Snake54310/Gloves/Technical Addendum/Flex_Gyro_Zeroing_Demo/Fist_1.jpg

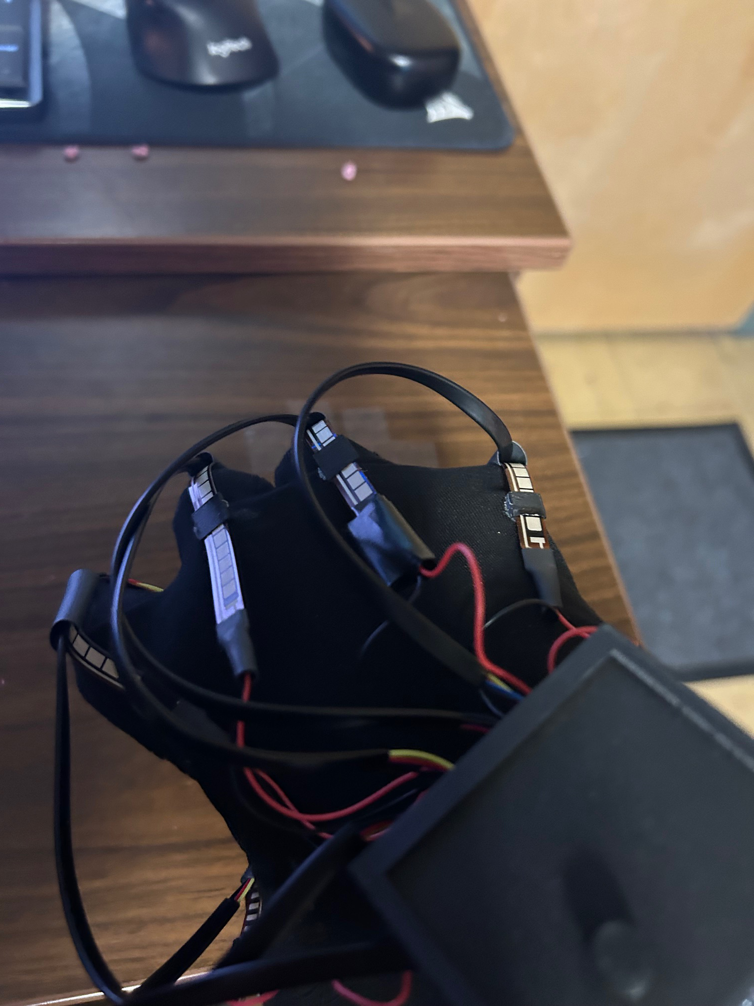
Technical Addendum/Flex_Gyro_Zeroing_Demo/Fist_1.jpg
