Snake54310/Gloves/Technical Addendum/Flex_Gyro_Zeroing_Demo/Fist_4.jpg

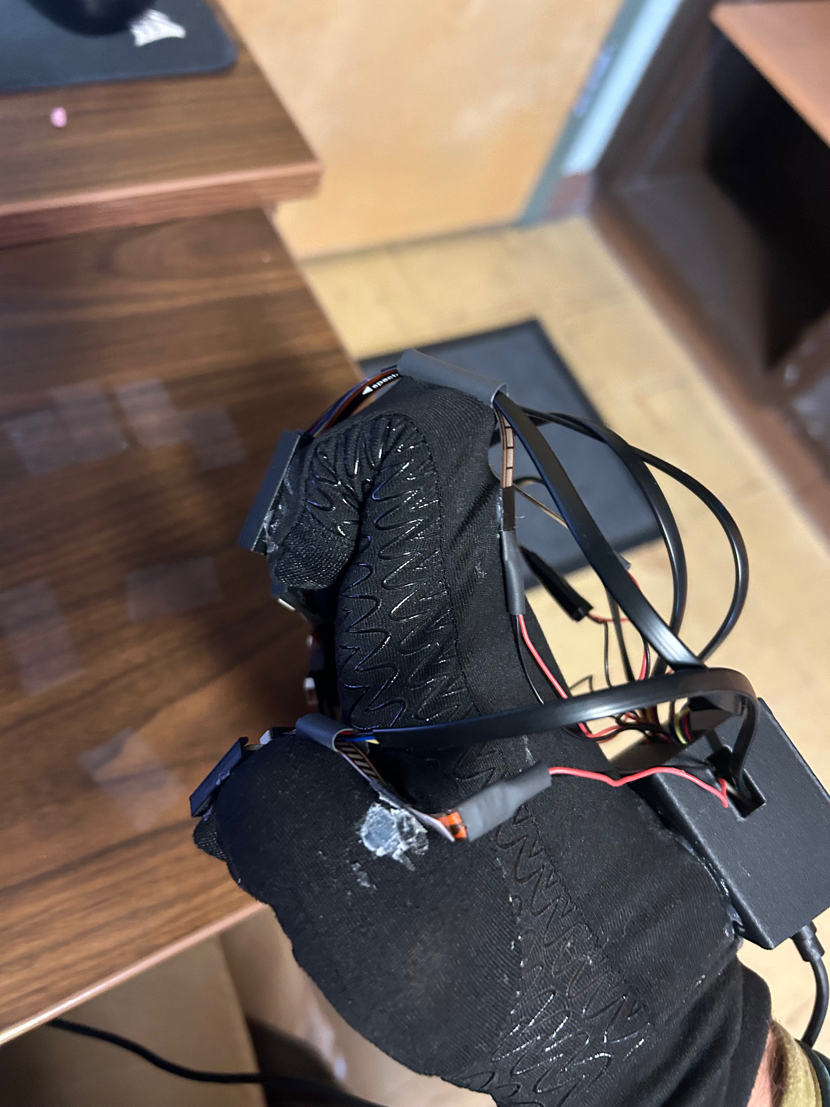
Technical Addendum/Flex_Gyro_Zeroing_Demo/Fist_4.jpg
