Snake54310/Gloves/Technical Addendum/Tech Addendum Drawings.docx

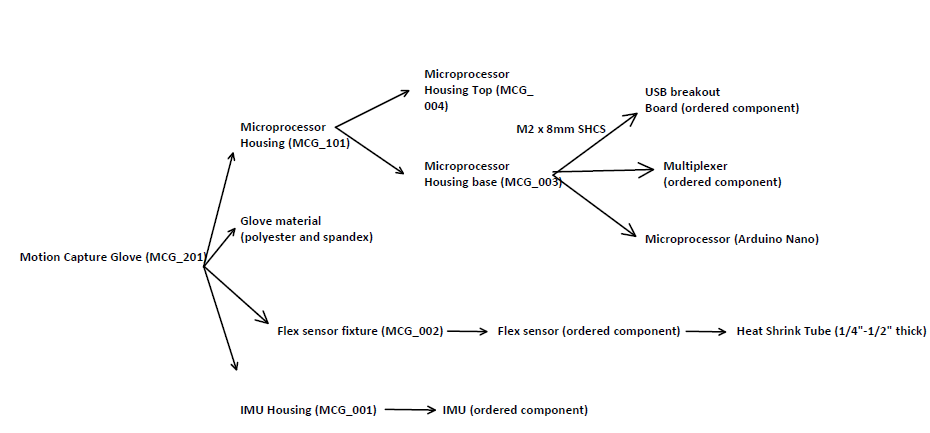
[picture p3: figure]

Figure xx: MoCap component diagram tree

All parts manufactured in-house should follow the same nomenclature as seen above. MCG_ indicating (MoCap glove), value in the tenths place indicates the file type: 200 – main assembly, 100 – sub-assembly, and 000 – single component. The hundredth and thousandth place are dedicated solely to which part you are working with. Drawings for the modeled component can be seen below.

Following the drawings are ECNs (Engineering Change Notification), created throughout the manufacturing process. The changes are direct products of trial and error upon printing the housing for the components. Each change is linked to a component and can be found in the upper right of the ECN document

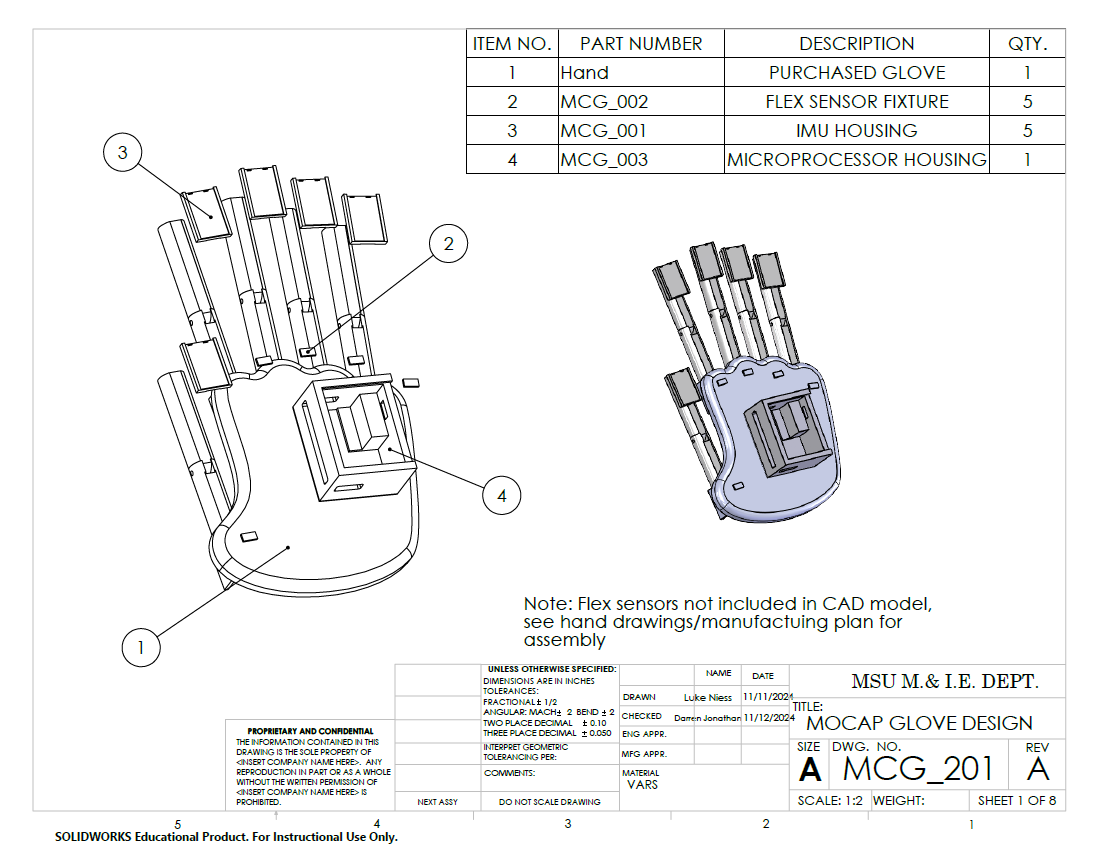
[picture p4: figure]
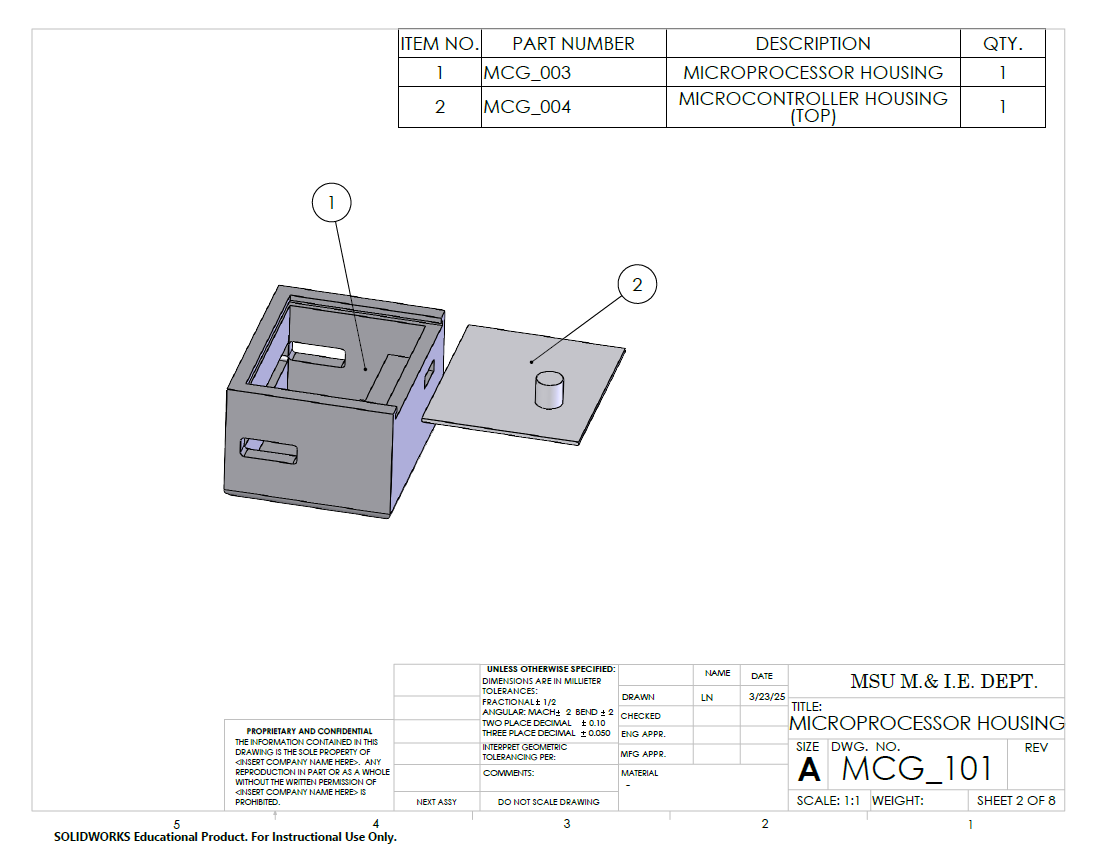
[picture p5: figure]
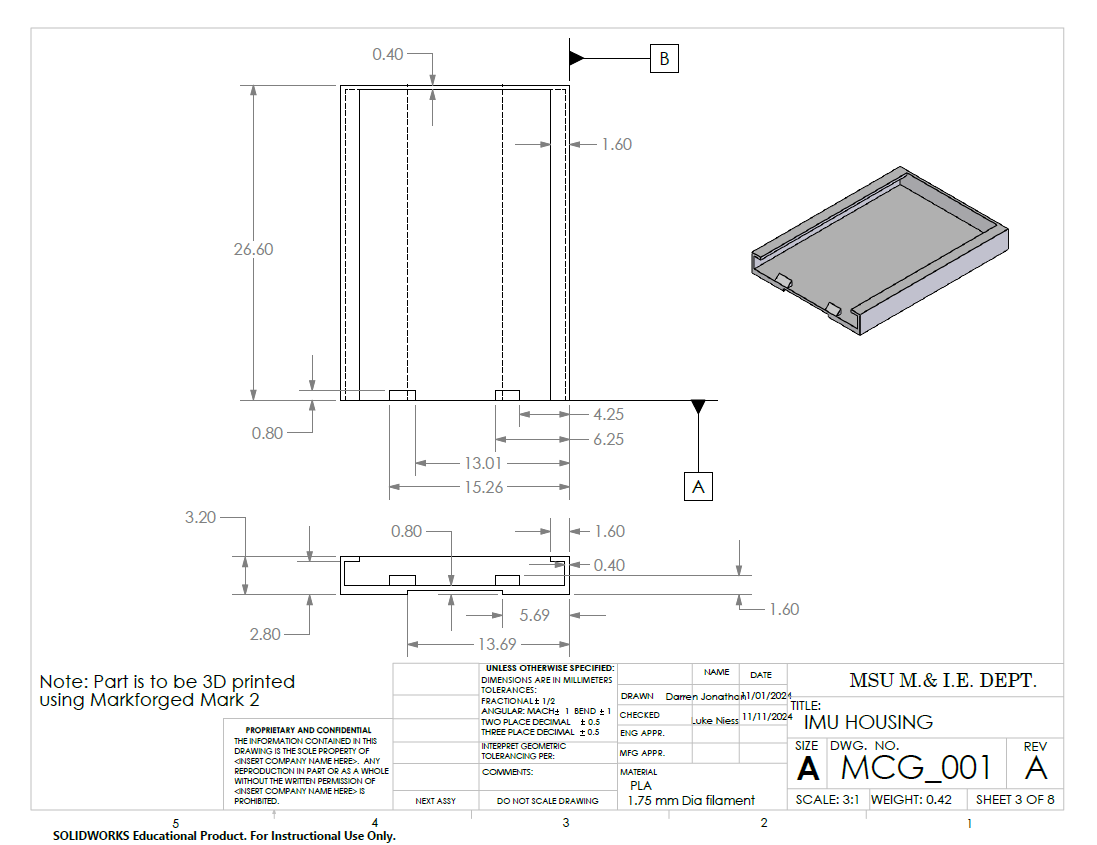
[picture p6: figure]
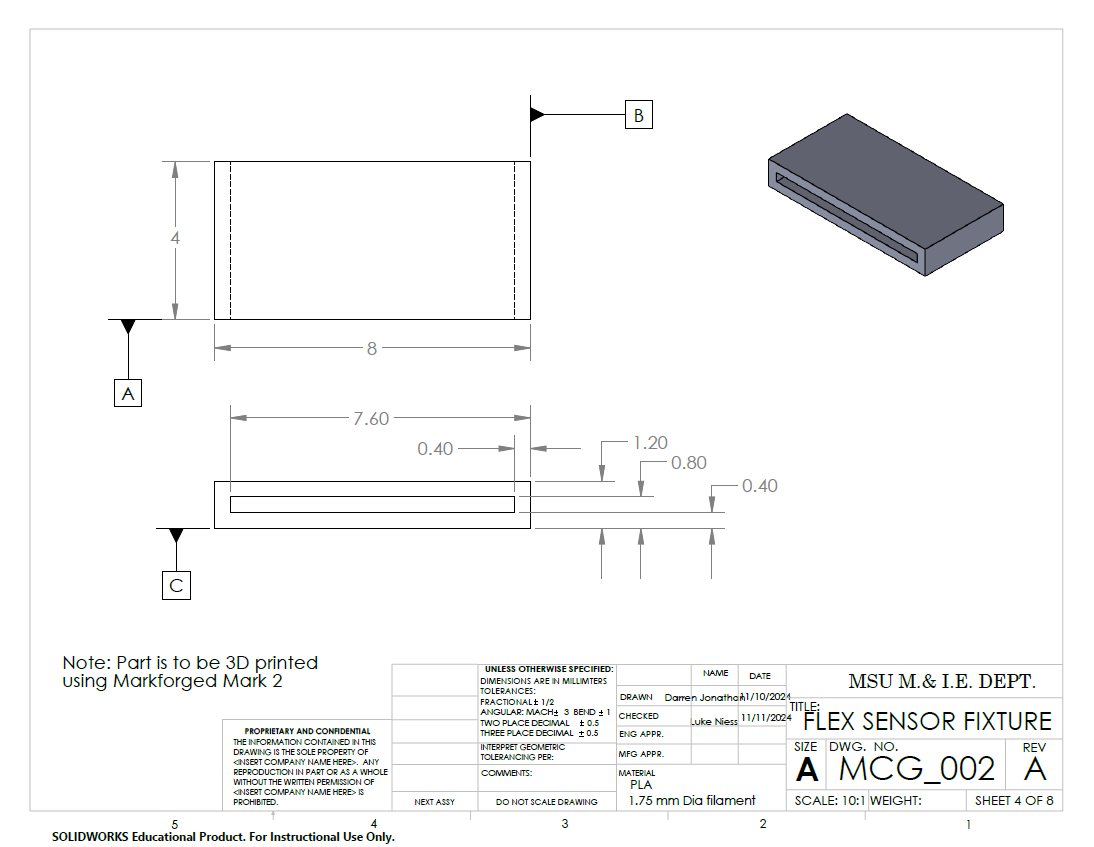
[picture p7: figure]
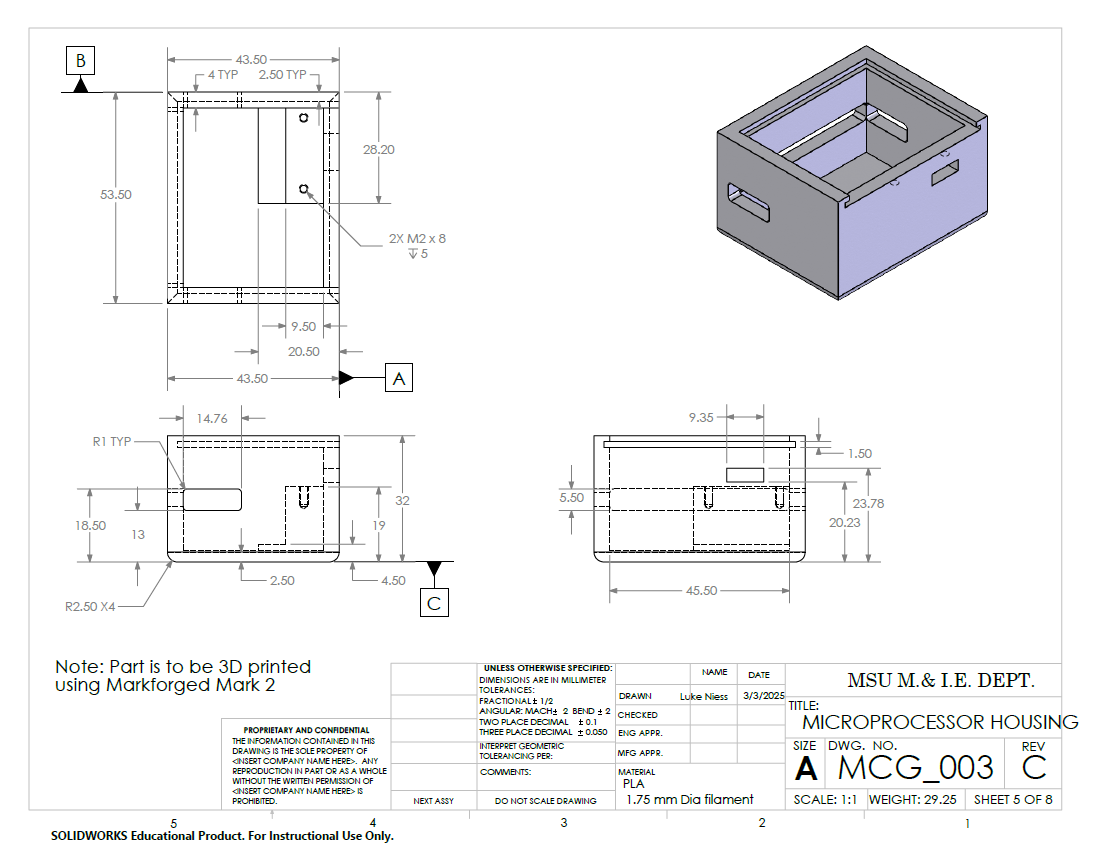
[picture p8: figure]
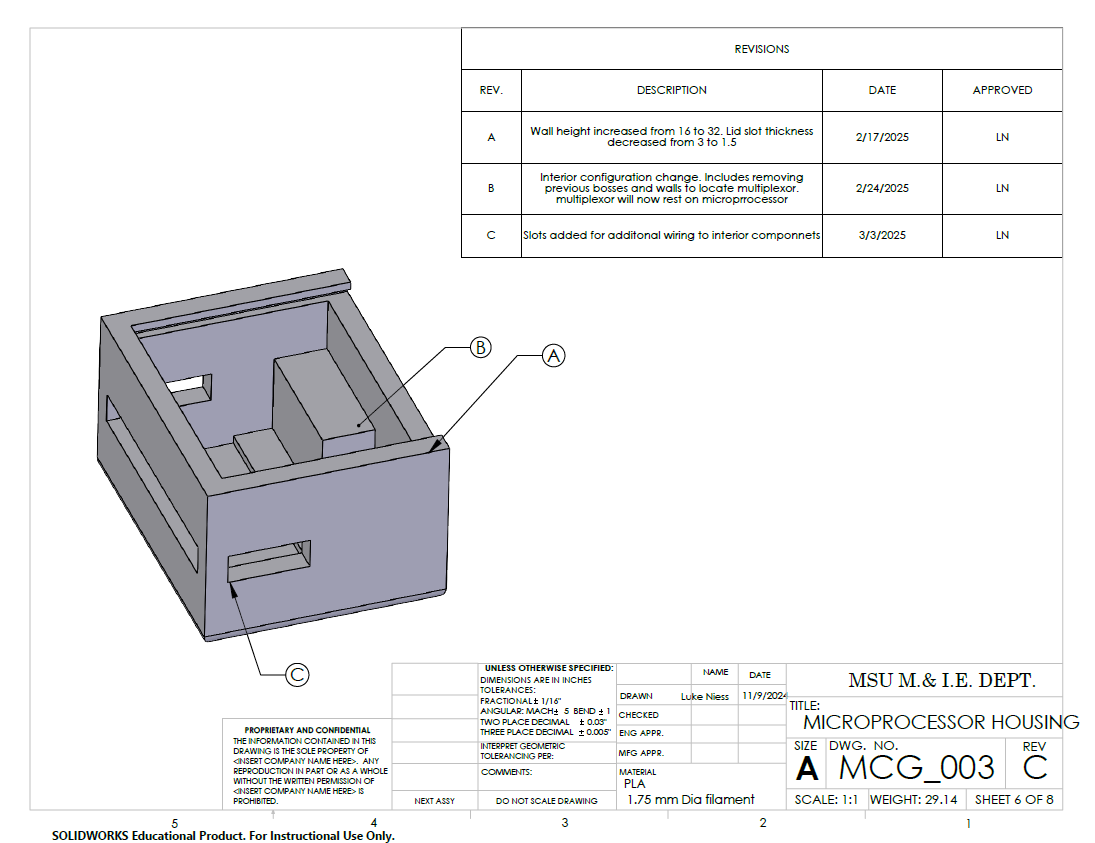
[picture p9: figure]
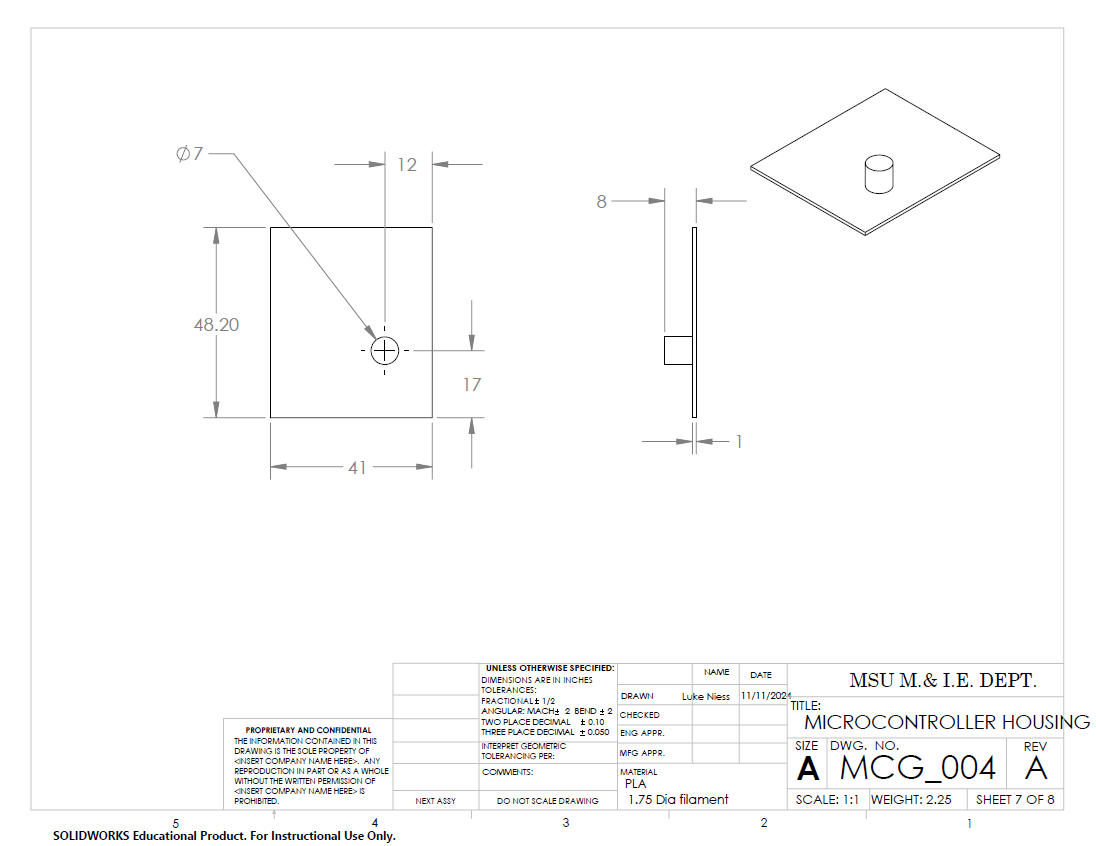
[picture p10: figure]
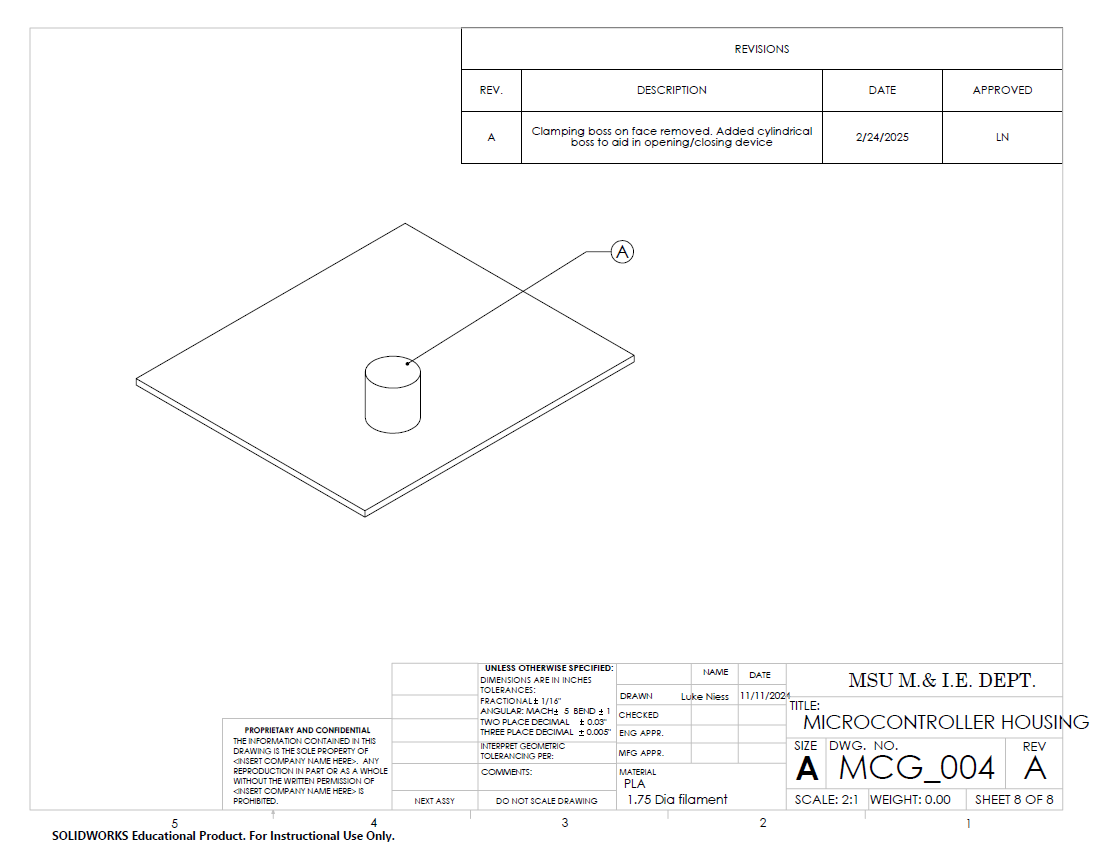
[picture p11: figure]
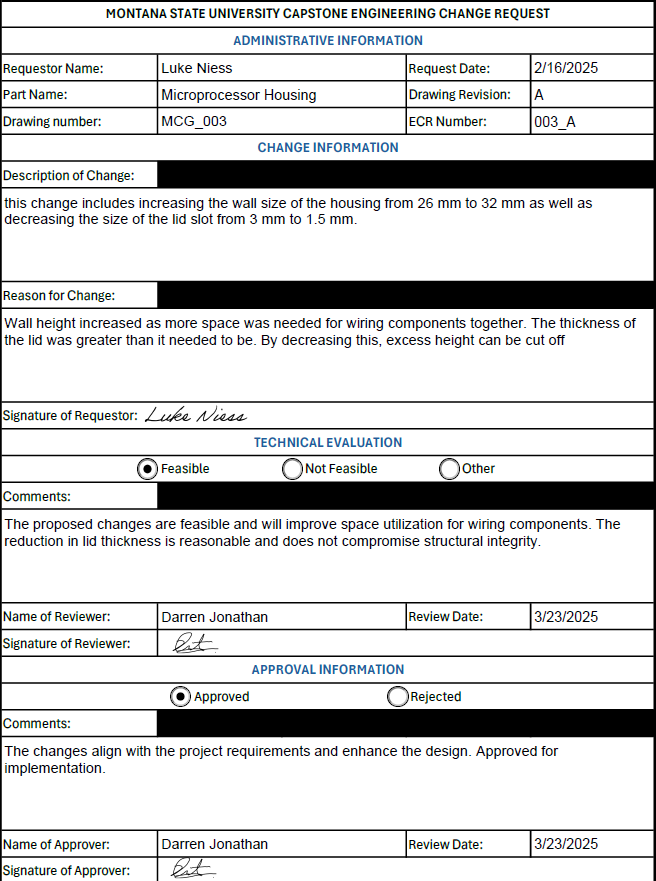
[picture p12: figure]
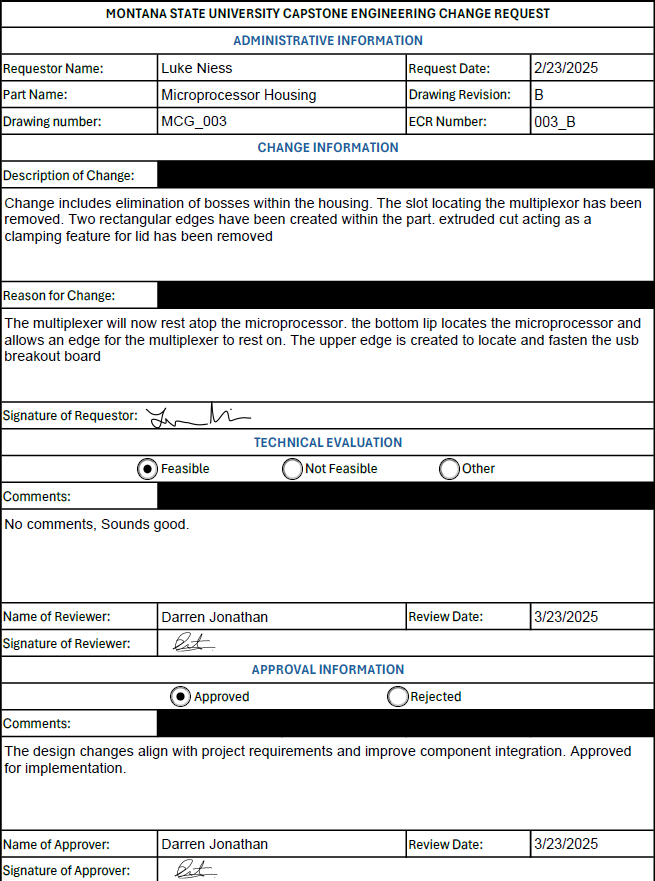
[picture p13: figure]
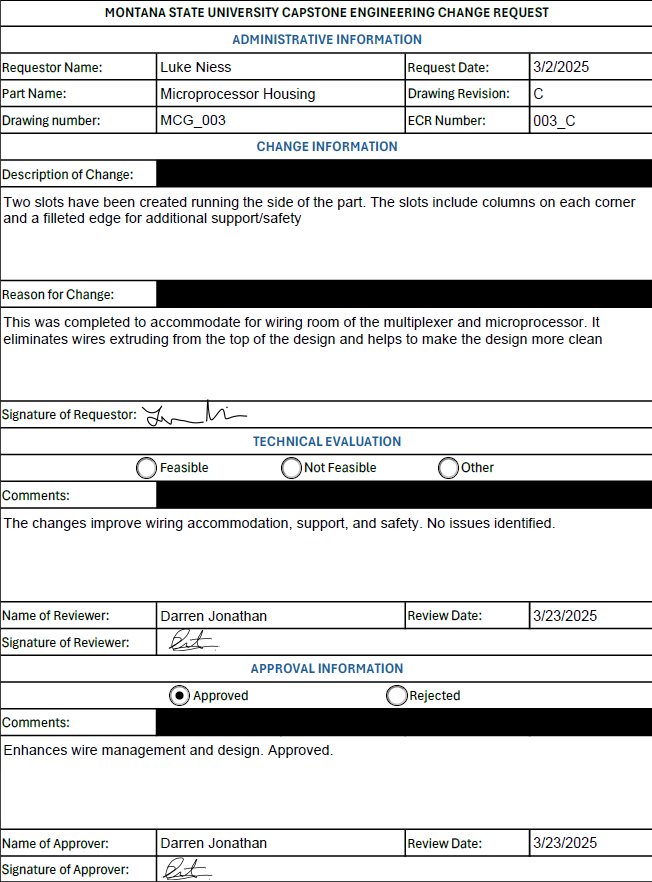
[picture p14: figure]
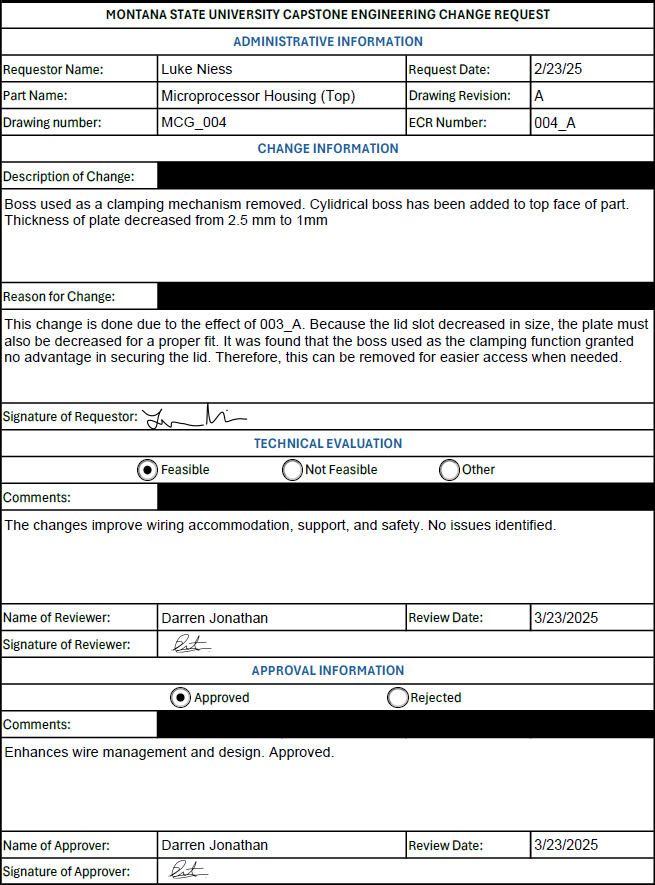
[picture p15: figure]
