Snake54310/Gloves/Technical Addendum/gantt_chart_final.pdf

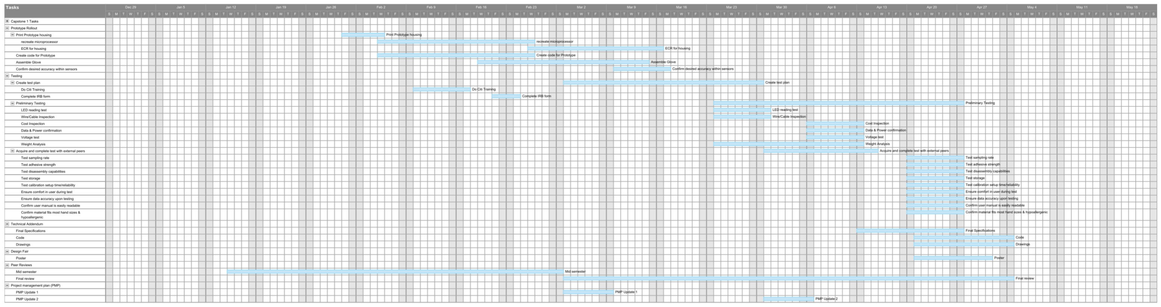
[picture p16: page 1]
