Snake54310/Gloves/Technical Addendum/Code Screenshots/arduino_1.jpg

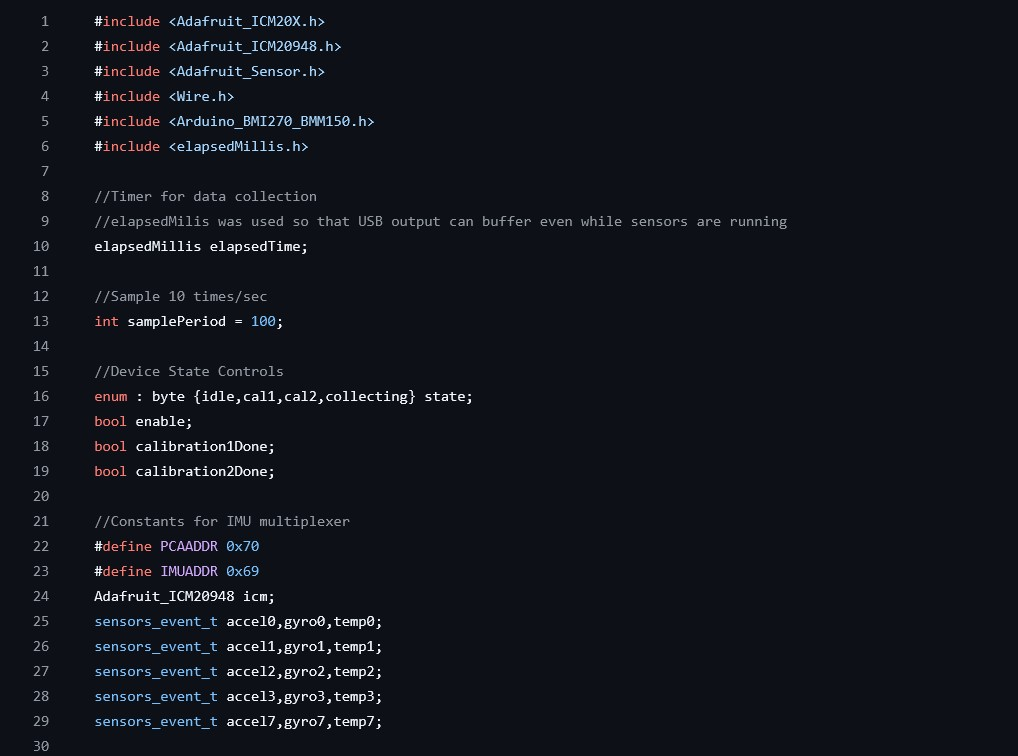
Technical Addendum/Code Screenshots/arduino_1.jpg
