Snake54310/Gloves/Technical Addendum/Code Screenshots/arduino_4_left.jpg

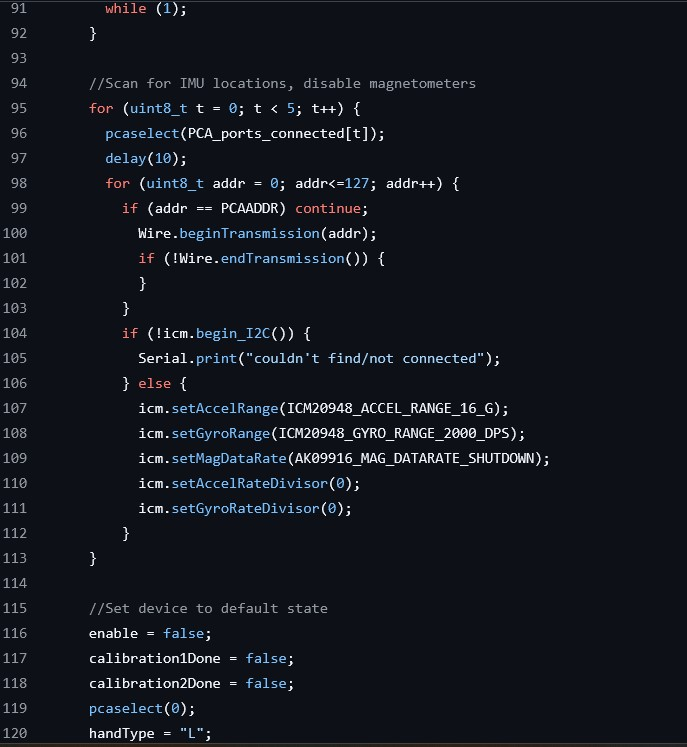
Technical Addendum/Code Screenshots/arduino_4_left.jpg
