Snake54310/Gloves/Technical Addendum/Code Screenshots/arduino_4_right.jpg

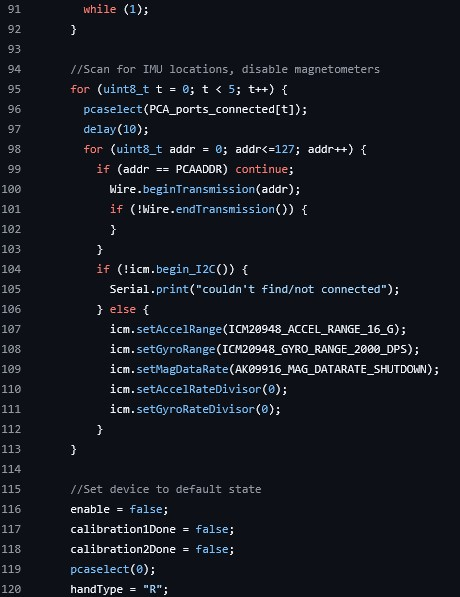
Technical Addendum/Code Screenshots/arduino_4_right.jpg
