Snake54310/Gloves/Technical Addendum/Code Screenshots/arduino_5.jpg

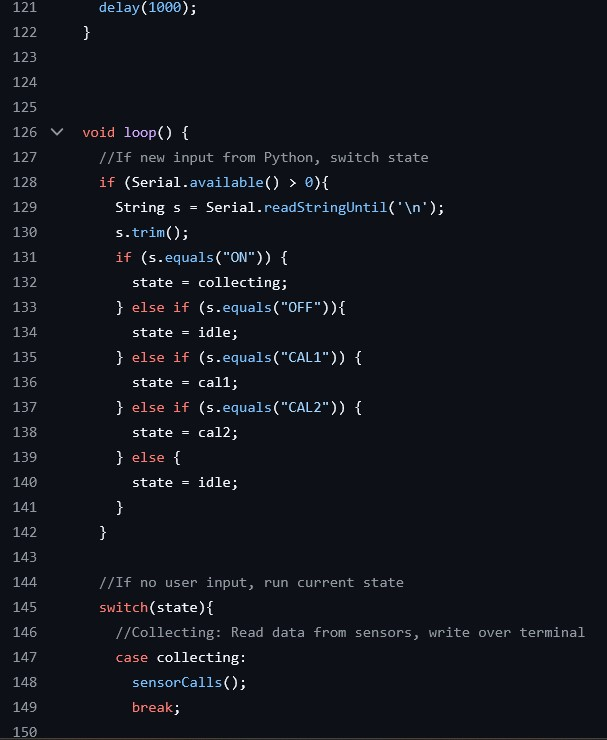
Technical Addendum/Code Screenshots/arduino_5.jpg
