Snake54310/Gloves/Technical Addendum/Code Screenshots/arduino_7.jpg

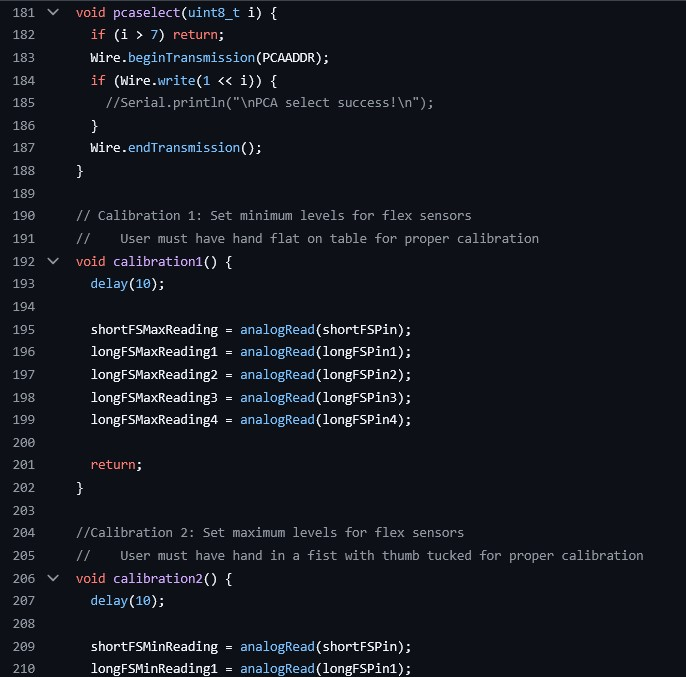
Technical Addendum/Code Screenshots/arduino_7.jpg
