Snake54310/Gloves/Technical Addendum/Code Screenshots/arduino_8.jpg

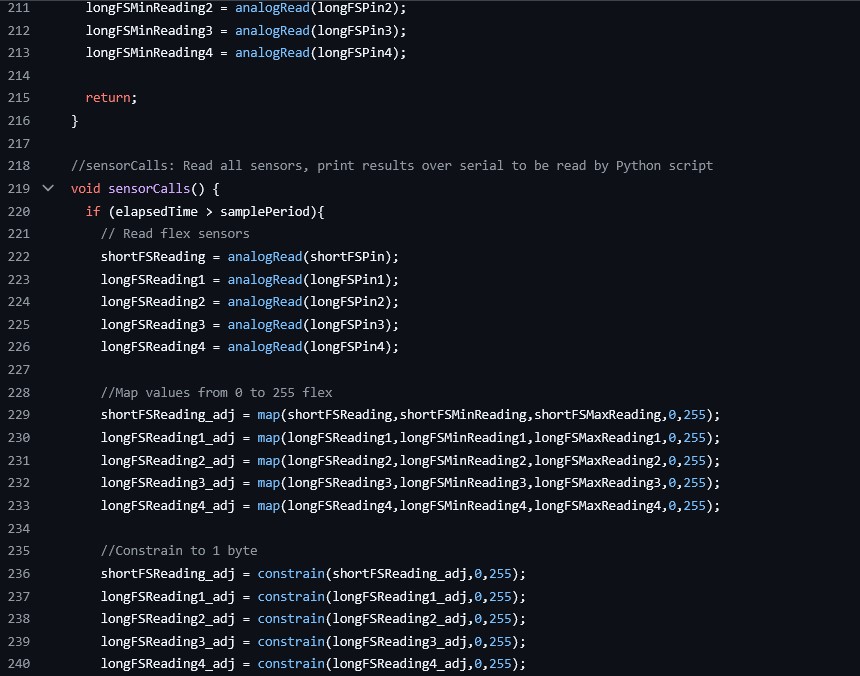
Technical Addendum/Code Screenshots/arduino_8.jpg
