Snake54310/Gloves/Technical Addendum/Code Screenshots/arduino_9.jpg

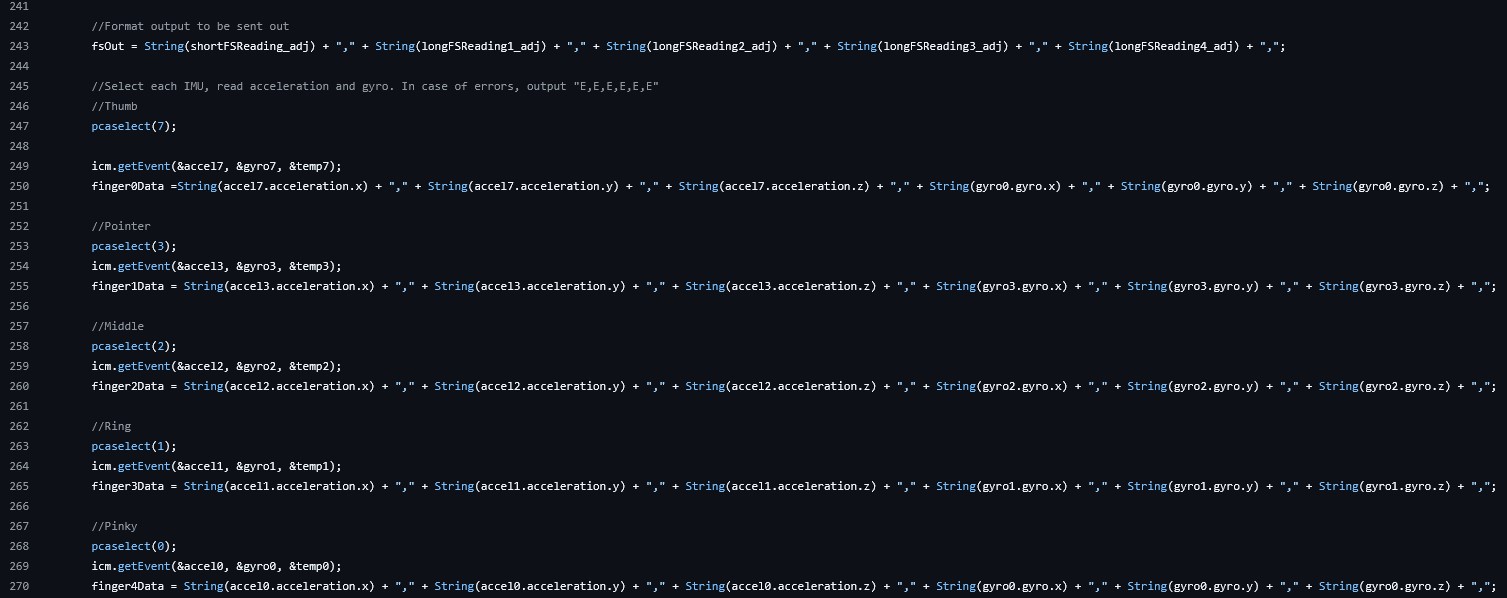
Technical Addendum/Code Screenshots/arduino_9.jpg
