Snake54310/Gloves/Technical Addendum/Code Screenshots/arduino_10.jpg

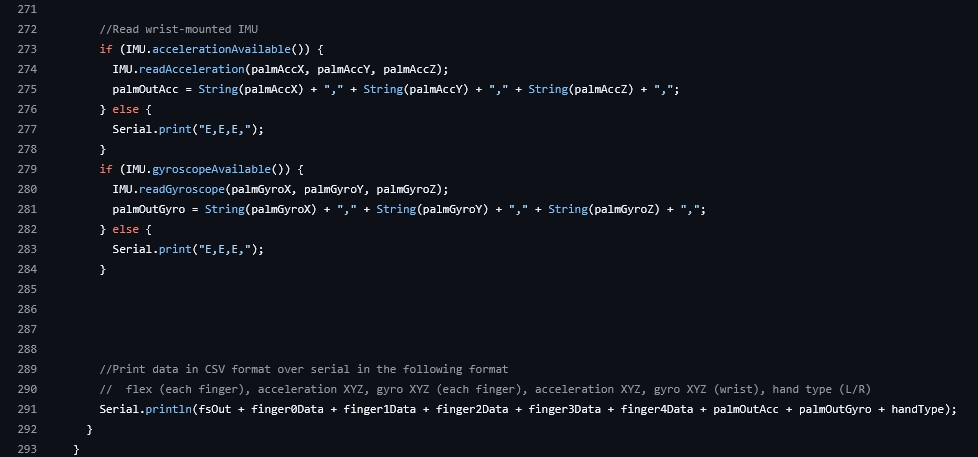
Technical Addendum/Code Screenshots/arduino_10.jpg
