Snake54310/Gloves/Technical Addendum/Flex_Gyro_Zeroing_Demo/Flat_2.jpg

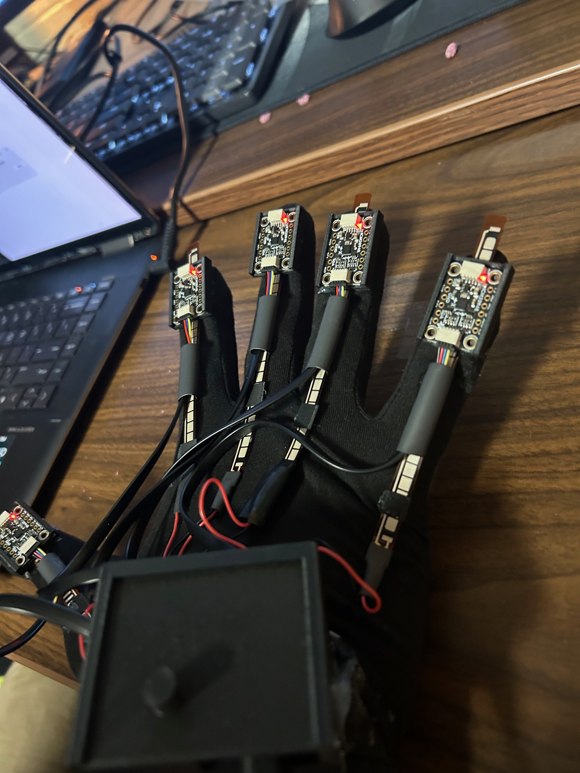
Technical Addendum/Flex_Gyro_Zeroing_Demo/Flat_2.jpg
