Snake54310/Gloves/Technical Addendum/Flex_Gyro_Zeroing_Demo/Gyro_Zeroing.jpg

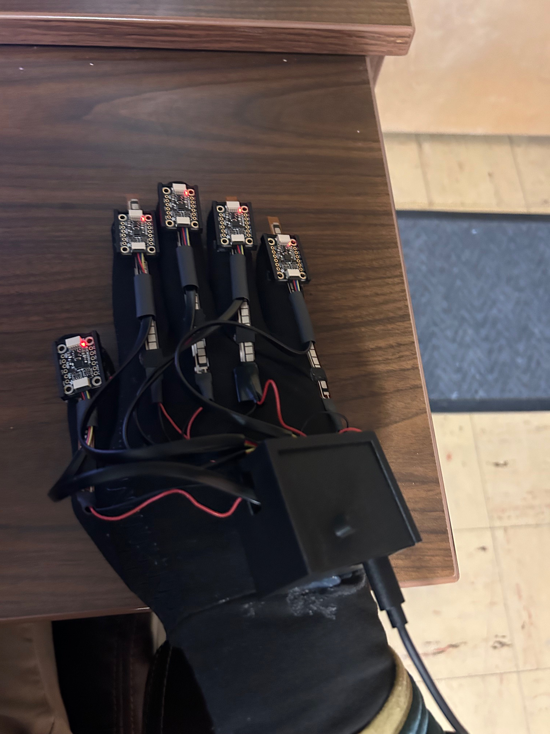
Technical Addendum/Flex_Gyro_Zeroing_Demo/Gyro_Zeroing.jpg
