Snake54310/Gloves/Technical Addendum/Position_Identification_Examples/No_Position_Hand.png

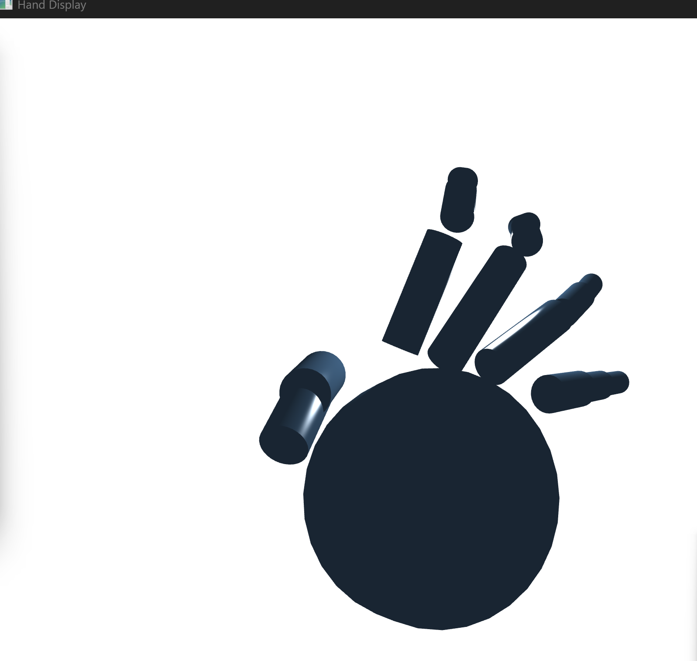
Technical Addendum/Position_Identification_Examples/No_Position_Hand.png
