Snake54310/Gloves/Technical Addendum/Position_Identification_Examples/Peace_Hand.png

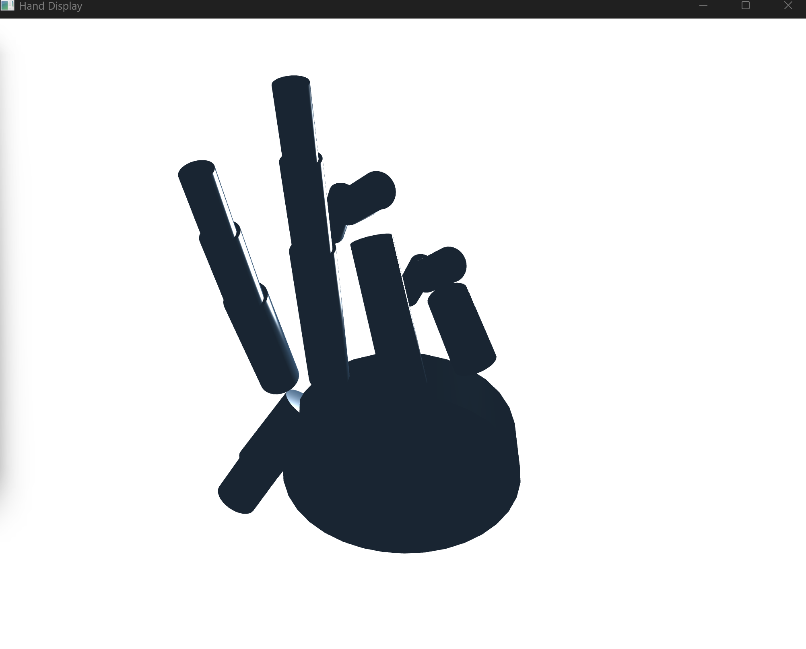
Technical Addendum/Position_Identification_Examples/Peace_Hand.png
