Snake54310/Gloves/Technical Addendum/Position_Identification_Examples/Point_Hand.png

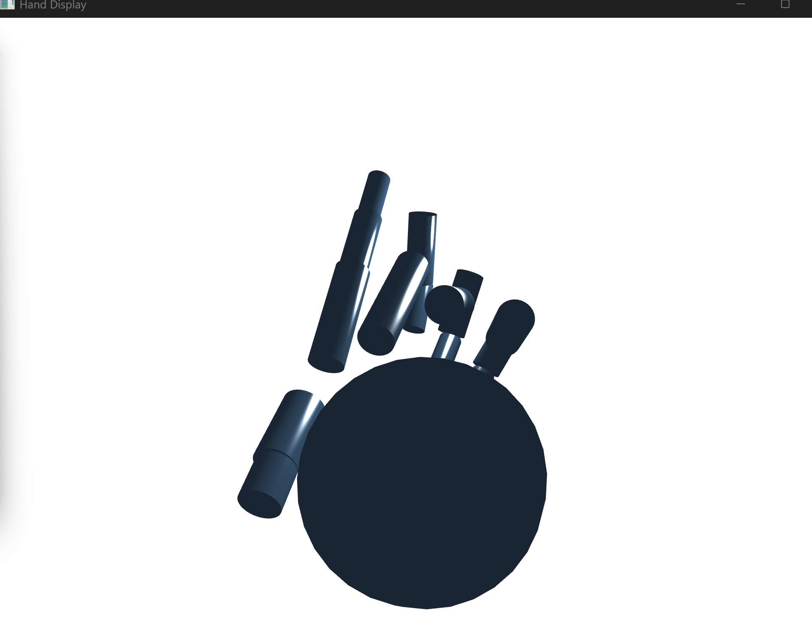
Technical Addendum/Position_Identification_Examples/Point_Hand.png
