Snake54310/Gloves/Technical Addendum/Position_Identification_Examples/Thumbs_Down_Hand.png

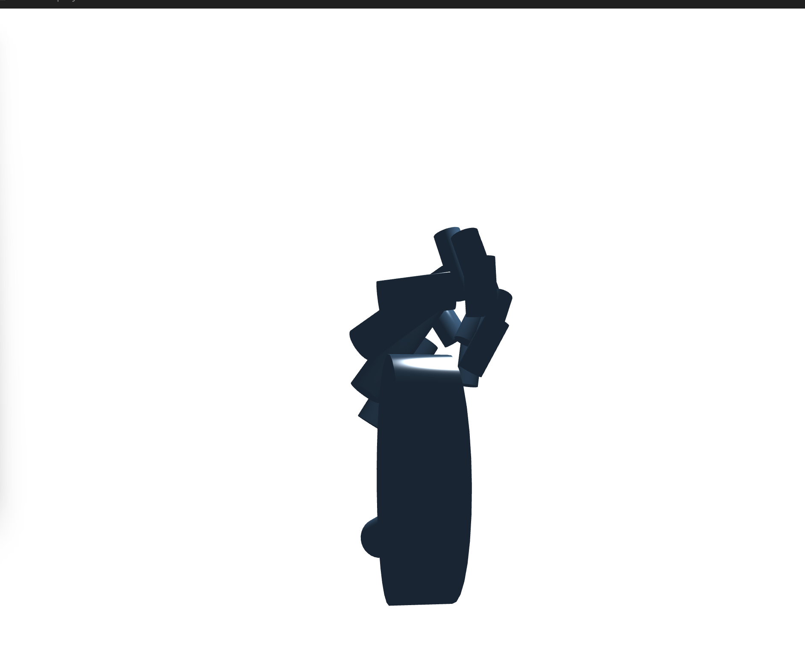
Technical Addendum/Position_Identification_Examples/Thumbs_Down_Hand.png
