Snake54310/Gloves/Technical Addendum/Position_Identification_Examples/Thumbs_Up_Hand.png

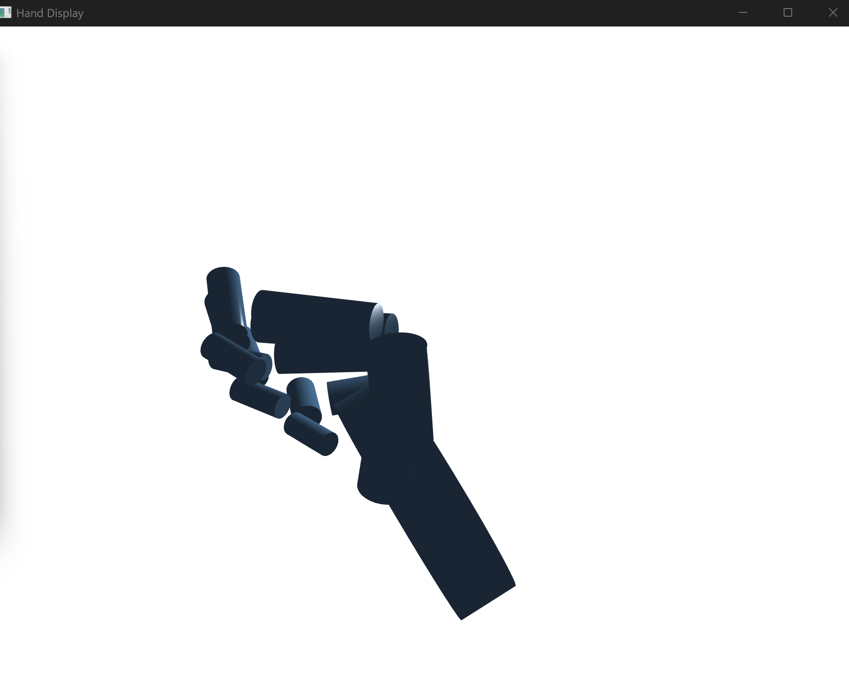
Technical Addendum/Position_Identification_Examples/Thumbs_Up_Hand.png
