Snake54310/Gloves/Technical Addendum/MoCap Zipped Drawing W models/MCG_003.5.SLDPRT

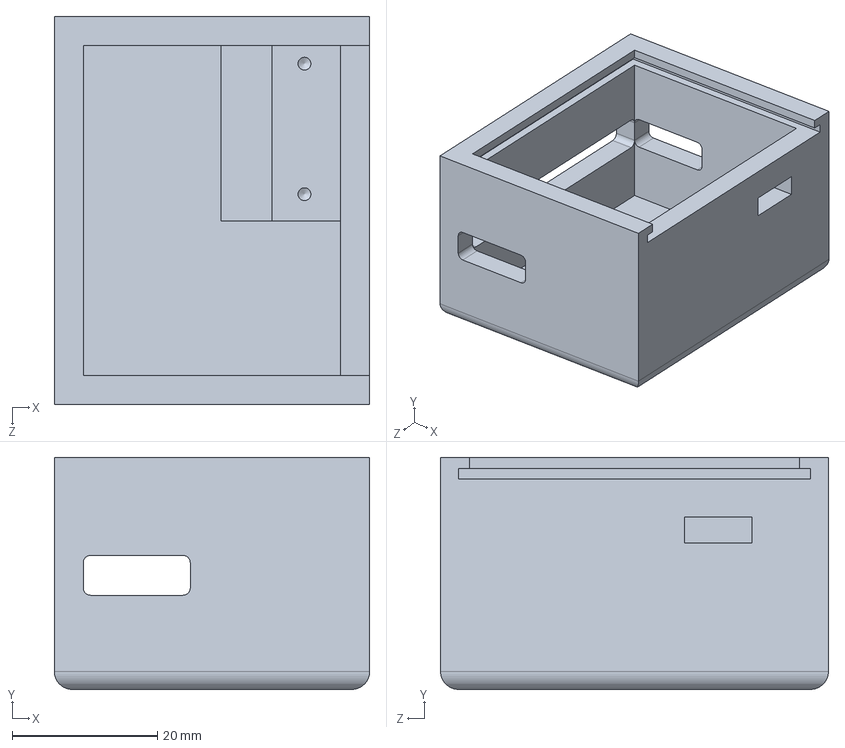
[picture p35: CAD file, 2026-01-28]
Technical Addendum/MoCap Zipped Drawing W models/MCG_003.5.SLDPRT
43.5 x 32.0 x 53.5 mm
