Snake54310/Gloves/Technical Addendum/MoCap Zipped Drawing W models/IMU housing.SLDPRT

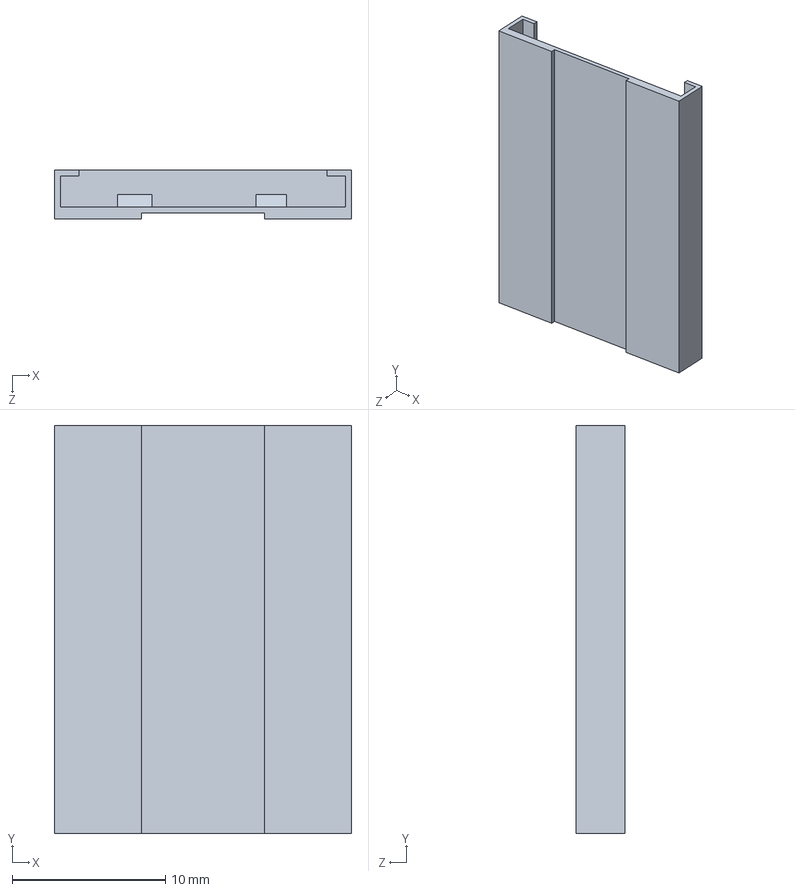
[picture p36: CAD file, 2026-01-28]
Technical Addendum/MoCap Zipped Drawing W models/IMU housing.SLDPRT
19.4 x 26.6 x 3.20 mm
