Snake54310/Gloves/Technical Addendum/MoCap Zipped Drawing W models/MCG_004.2.SLDPRT

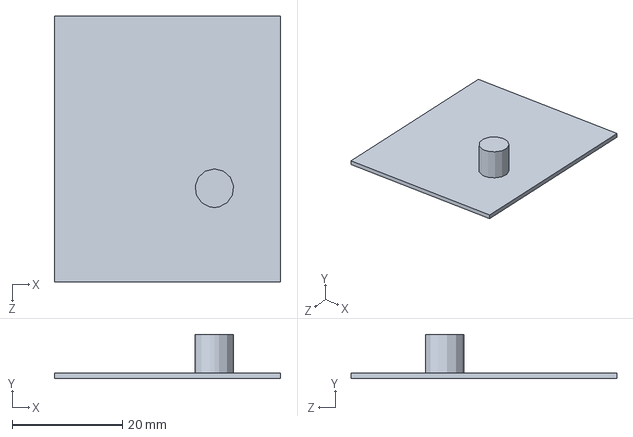
[picture p37: CAD file, 2026-01-28]
Technical Addendum/MoCap Zipped Drawing W models/MCG_004.2.SLDPRT
41.0 x 8.00 x 48.2 mm
