Snake54310/Gloves/Technical Addendum/MoCap Zipped Drawing W models/Flex Fixed.SLDPRT

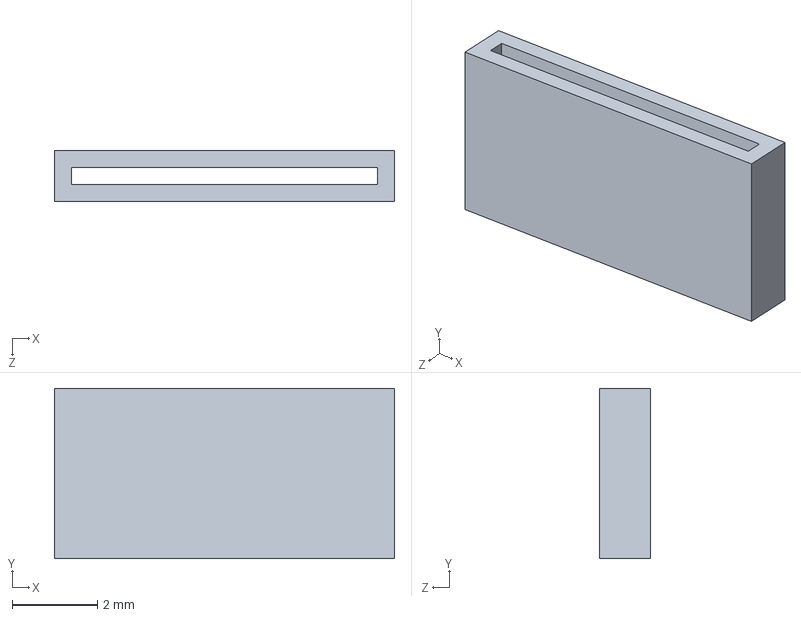
[picture p38: CAD file, 2026-01-28]
Technical Addendum/MoCap Zipped Drawing W models/Flex Fixed.SLDPRT
8.00 x 4.00 x 1.20 mm
