Snake54310/Gloves/Technical Addendum/MoCap Zipped Drawing W models/MCG_201.SLDASM

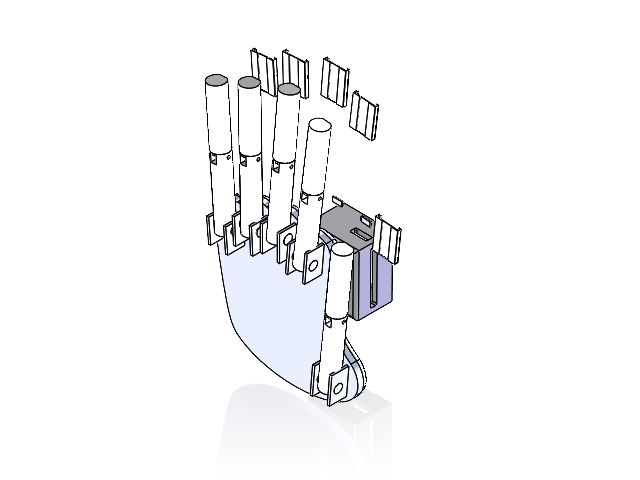
[picture p39: CAD file, 2026-01-28]
Technical Addendum/MoCap Zipped Drawing W models/MCG_201.SLDASM
Palm
Metacarp joint x 5
Metacarp(pointer) x 5
Phalanges(finger tip) x 5
Flex Fixed x 5
IMU housing x 5
MCG_003.5
