Snake54310/Gloves/Technical Addendum/MoCap Zipped Drawing W models/MCG_101.2.SLDASM

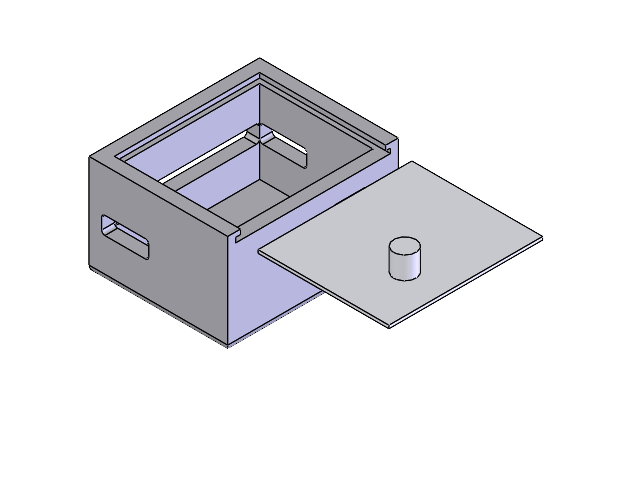
[picture p40: CAD file, 2026-01-28]
Technical Addendum/MoCap Zipped Drawing W models/MCG_101.2.SLDASM
MCG_003.5 (1)
MCG_004.2
