Snake54310/Gloves/(list of files, cad)

Other CAD files:
Technical Addendum/MoCap Zipped Drawing W models/MCG_001.SLDDRW
Technical Addendum/MoCap Zipped Drawing W models/MCG_002.SLDDRW
Technical Addendum/MoCap Zipped Drawing W models/MCG_003.5 Revision sheet.SLDDRW
Technical Addendum/MoCap Zipped Drawing W models/MCG_003.5.SLDDRW
Technical Addendum/MoCap Zipped Drawing W models/MCG_004.2 Revision sheet.SLDDRW
Technical Addendum/MoCap Zipped Drawing W models/MCG_004.2.SLDDRW
Technical Addendum/MoCap Zipped Drawing W models/MCG_101.2.SLDDRW
Technical Addendum/MoCap Zipped Drawing W models/MCG_201.SLDDRW
