Snake54310/Gloves/Technical Addendum/Code/Python/gyro_calibration/data/raw/gyro_log.csv

episode_id | timestamp | wx | wy | wz | marker
1 | 13.341 | 0.001672380381229075 | 0.018410772561820735 | -0.007026491384076877 | start
1 | 13.392 | 0.010365252387993512 | 0.01990140346579581 | -0.007418816713161739
1 | 13.443 | 0.03539196182802922 | 0.024078680979969305 | -0.007275289589614138
1 | 13.495 | 0.11989566934315807 | 0.02863929998607891 | -0.02607965364380392
1 | 13.545 | 0.3064500124405881 | 0.040309416935963904 | -0.08223653337817262
1 | 13.596 | 0.5884548702122443 | 0.06845507438847497 | -0.1331356902717604
1 | 13.647 | 0.9019934578330812 | 0.1103288156743566 | -0.12998048492654662
1 | 13.698 | 1.200326094860931 | 0.17451324910014876 | -0.08036088045174242
1 | 13.749 | 1.4892411507843752 | 0.2713480591950407 | -0.012157388356647186
1 | 13.8 | 1.7605550318685095 | 0.394398350639649 | 0.047423361815645826
1 | 13.851 | 1.9819147618980641 | 0.5330127726179689 | 0.08242838569768582
1 | 13.902 | 2.128952020810552 | 0.6732855683953533 | 0.10147049248311
1 | 13.953 | 2.2042595834765044 | 0.8037550327254815 | 0.109548374092565
1 | 14.004 | 2.2329359865895966 | 0.9242843958572209 | 0.10090789432051925
1 | 14.055 | 2.2402467664595807 | 1.0464294804494463 | 0.08203835376265241
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
