Snake54310/Gloves/Technical Addendum/Code/Python/gyro_calibration/data/raw/gyro_stationary.csv

episode_id | timestamp | wx | wy | wz | marker
1 | 21.757 | 0.0110119844610906 | 0.0187497508367977 | -0.0085451084614029 | start
1 | 21.808 | 0.0102820994016698 | 0.0185088383633194 | -0.0085339467010777
1 | 21.859 | 0.0085863225407156 | 0.0178716179880496 | -0.0086445612262812
1 | 21.91 | 0.0074114653919169 | 0.0168305813937454 | -0.0090252247673641
1 | 21.96 | 0.007066748555418 | 0.0158150203758695 | -0.0097493382955641
1 | 22.012 | 0.0070813021263483 | 0.0150982153464601 | -0.010233886143176
1 | 22.063 | 0.0075259388425629 | 0.014630601359533 | -0.0101241954555649
1 | 22.114 | 0.0086123581499224 | 0.014561205137184 | -0.0098430344577708
1 | 22.165 | 0.0098222762291463 | 0.0147527813294376 | -0.009675321004856
1 | 22.215 | 0.0104117025603761 | 0.0148955089467355 | -0.009393006656036
1 | 22.267 | 0.0103549912411028 | 0.0151962753073385 | -0.0088590384798079
1 | 22.319 | 0.0094867670512244 | 0.0157750721115974 | -0.0084074009022869
1 | 22.369 | 0.0077661579775339 | 0.0162848537616505 | -0.0080448477911635
1 | 22.42 | 0.0060387603429578 | 0.0165085862558184 | -0.0075677206306078
1 | 22.471 | 0.0050482776540226 | 0.0165308874780234 | -0.0070554405039712
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
