Snake54310/Gloves/(commit log)

2026-01-28 Basic Pyside formatted, low-pass filter integrated, live information can be selected/displayed
    [GloveData.csv]
2026-02-04 Added anglular metrics for flex data
    [GloveData.csv, flex sensor angles.xlsx]
2026-02-05 got an adjusted template together to animate individual fingers based on flex sensors, next will re-draw as something closer to complete hand
    [GloveData.csv]
2026-02-06 made slight changes, nothing major
    [GloveData.csv]
2026-02-07 Hand skeleton now animates finger flexing
    [GloveData.csv]
2026-02-10 gyro reads accurate for wrist and zeroing option available
    [GloveData.csv]
2026-02-12 Day 7, integrating wrist gyroscope data into animationcomplete
    [GloveData.csv]
2026-02-26 live animation functioning as much as filtered sensor data will allow, next will add more options for leveling and see if an AI can be trained to estimate drift based on sensor data history.
    [GloveData.csv]
2026-03-04 added recording for wrist gyro data, recorded initial test data. Will attempt training on separate machine
    [GloveData.csv, wristGyro.csv]
2026-03-05 created training methods, first fix attempted
    [gyro_log.csv]
2026-03-05 added quadratic drift term and better testing
    [RightHand.py]
2026-03-05 prevented full negation of movement
    [RightHand.py]
2026-03-05 trying something else
    [gyro_log.csv, gyro_stationary.csv]
2026-03-05 more data
    [GloveData.csv, gyro_log.csv, gyro_stationary.csv]
2026-03-05 more changes
    [gyro_log.csv, gyro_stationary.csv]
2026-03-05 more data again
    [GloveData.csv, gyro_log.csv, gyro_stationary.csv]
2026-03-07 new data collection, doubled frequency
    [GloveData.csv, gyro_log2.csv]
2026-03-07 got another model, improved slightly
    [gyro_log.csv]
2026-03-07 more training
    [gyro_log.csv]
2026-03-08 AI correction substantially improved
    [RightHand.py]
2026-03-08 small touch-up, massive improvement in gyroscope tracking
    [GloveData.csv]
2026-03-14 more data, finger data
    [GloveData.csv, gyro_log2.csv, gyro_log_mid.csv, gyro_log_mid_s.csv, gyro_log_pink.csv, gyro_log_pink_s.csv, gyro_log_point.csv, gyro_log_point_s.csv]
2026-03-14 calibrated training method for finger gyroscopes, results more modest than with wrist
    [gyro_log.csv, gyro_log2.csv, gyro_stationary.csv]
2026-04-06 verified refactored right-hand code, left-hand behaves differently for some reason
    [GloveData.csv]
2026-04-09 created seperate folders for right hand and left hand programsn, fixed issue with sensor failure on left hand arduino code, filtered stationary data on csv files
    [GloveData.csv, gyro_log_mid_s.csv, gyro_log_pink_s.csv, gyro_log_point_s.csv, gyro_log_ring_s.csv, gyro_log_thumb_s.csv, gyro_stationary.csv]
2026-04-09 did training again
    [gyro_log.csv, gyro_stationary.csv]
2026-04-09 fixed some things
    [GloveData.csv]
2026-04-29 added a bunch of crap
    [GloveData.csv]
2026-04-29 made some changes
    [GloveData_Left.csv, GloveData_Right.csv]
2026-04-30 Position identification in right hand working correctly
    [GloveData.csv, PositionData_Continuous.csv, PositionData_Snapshots.csv]
2026-05-02 completed project goals
    [GloveData.csv, PositionData_Snapshots.csv, flex sensor angles.xlsx, gyro_log.csv, gyro_log2.csv, gyro_log_mid.csv, gyro_log_mid_s.csv, gyro_log_pink.csv]
